bwack/VersaZIF64/README.md

# VersaZIF64

For gerbers please click the releases tab.
This project is based on the [Versa64Cart project](https://github.com/bwack/Versa64Cart).

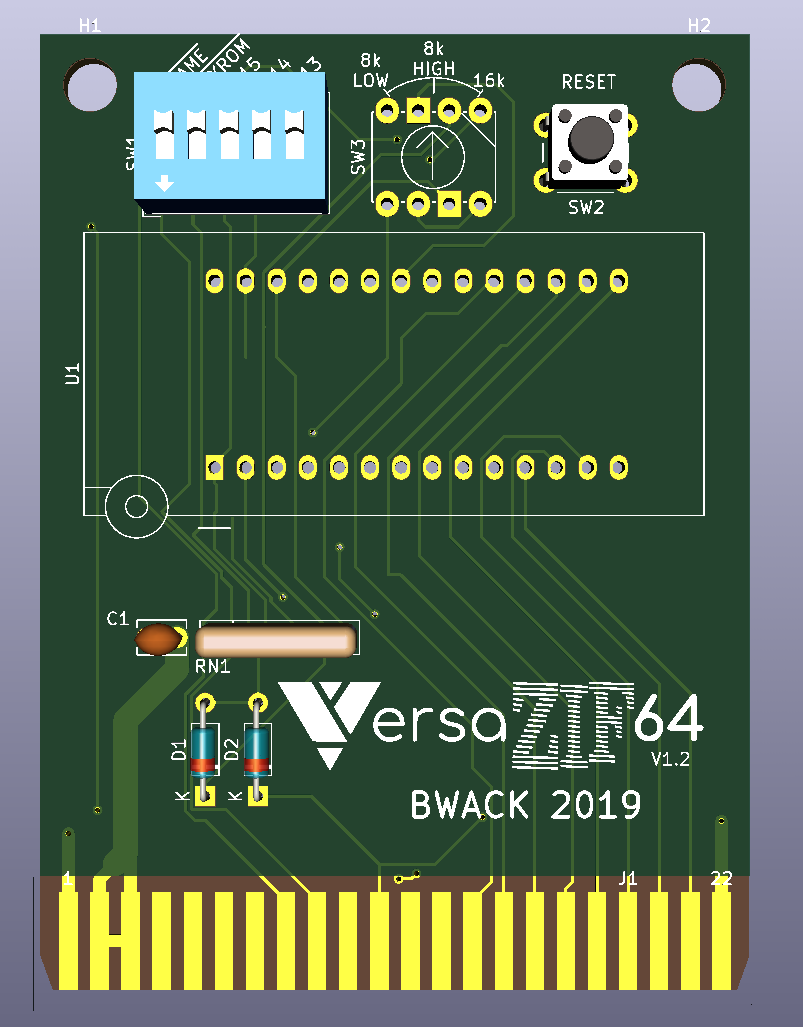
[picture p1: VersZIF64cart_3D.png]
VersaZIF64 3D
