bwack/VersaZIF64/VersZIF64cart.pdf

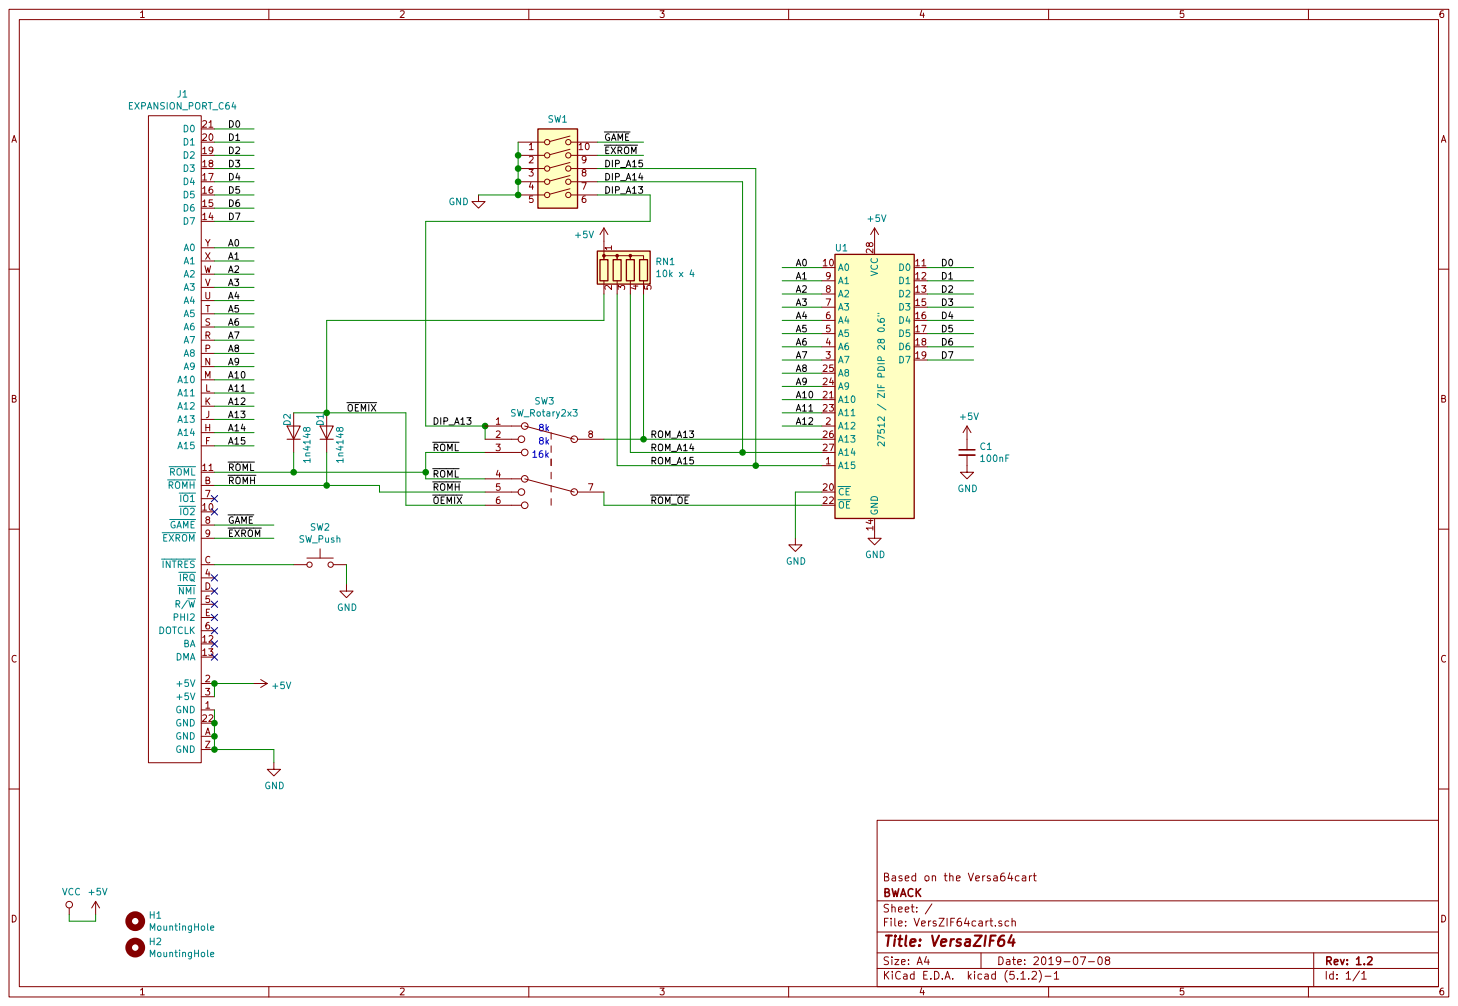
[picture p2: page 1]

File: VersZIF64cart.sch Sheet: / BWACK
