bwack/VersaZIF64/(list of files, drawings)

Other design files:
VersZIF64cart.dsn
