bwack/VersaZIF64/VersZIF64cart.kicad_pcb

## KiCad design VersZIF64cart.kicad_pcb (2019-07-08)

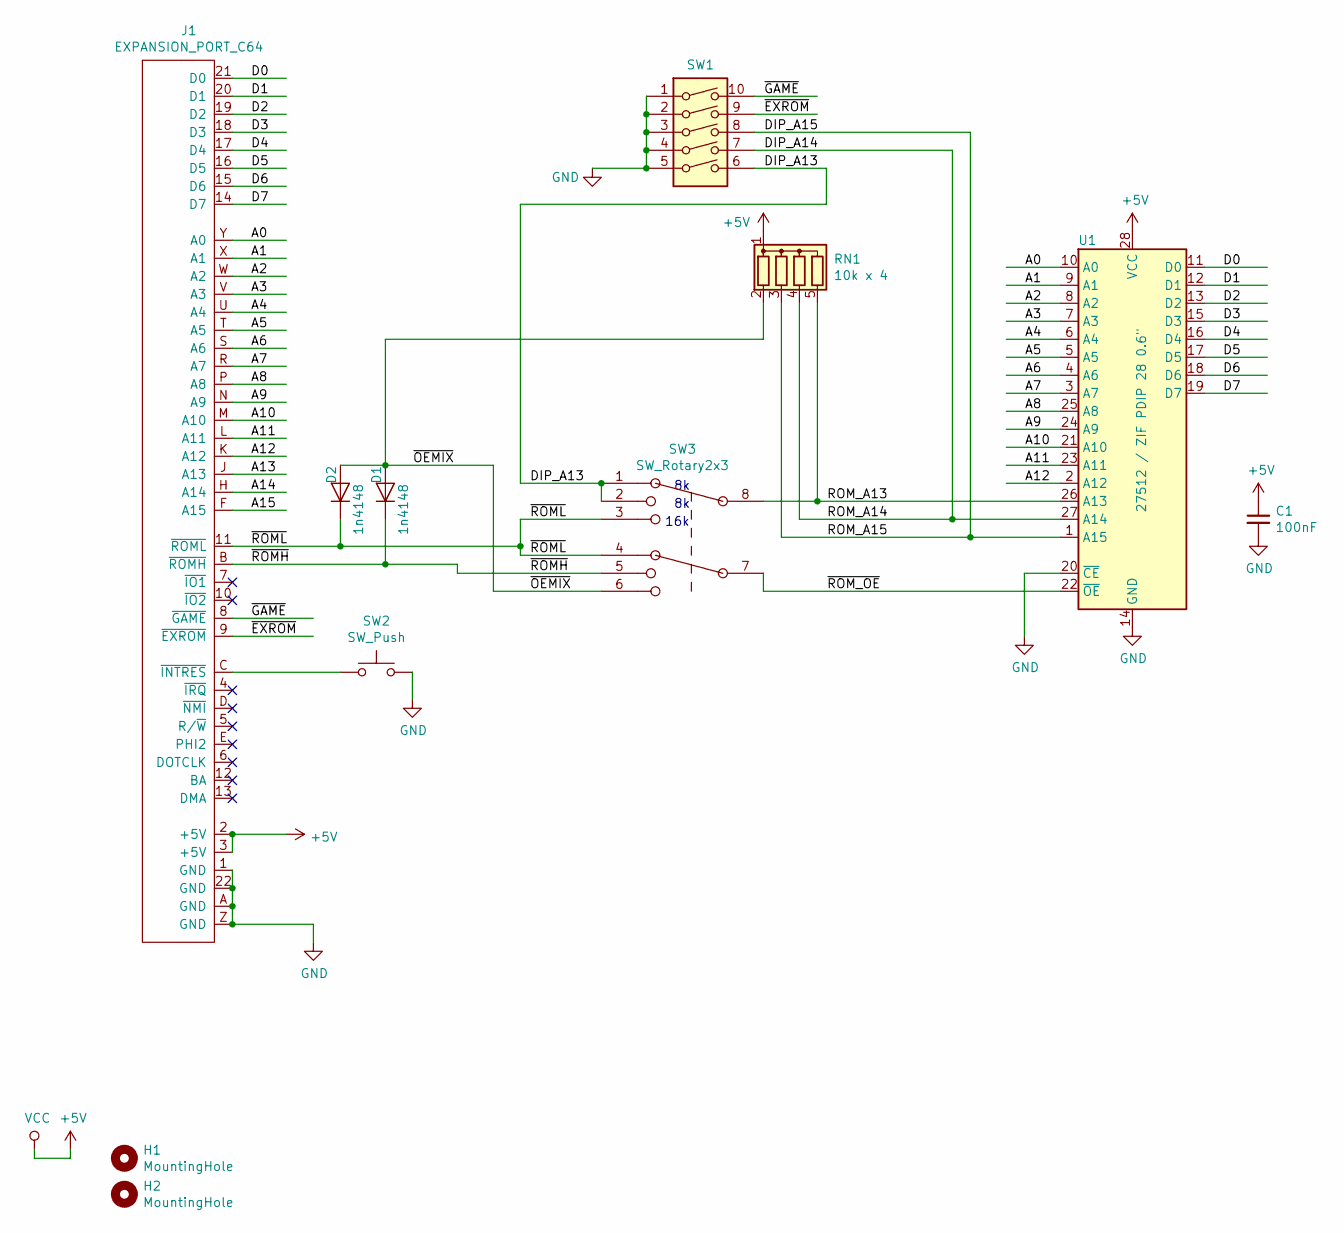
[picture p3: schematic VersZIF64cart.sch, VersaZIF64]

Parts:
C1: 100nF; C_Disc_D3.8mm_W2.6mm_P2.50mm
D1, D2: 1n4148; D_DO-35_SOD27_P7.62mm_Horizontal
H1, H2: MountingHole; MountingHole_4.3mm_M4_ISO7380
J1: EXPANSION_PORT_C64; C64_EXPANSION_PORT
RN1: 10k x 4; R_Array_SIP5
SW1: SW_DIP_x05; SW_DIP_SPSTx05_Slide_9.78x14.88mm_W7.62mm_P2.54mm
SW2: SW_Push; SW_PUSH_6mm_H5mm
SW3: SW_Rotary2x3; Nidec_SS-10-23NP-L-E_RotarySwitch_2x3
U1: 27512 / ZIF PDIP 28 0.6\"; DIP_Socket-28_W11.9_W12.7_W15.24_W17.78_W18.5_3M_228-1277-0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

Connections:
+5V: C1.1, J1.2 (+5V), J1.3 (+5V), RN1.1 (common), U1.28 (VCC)
/A0: J1.Y (A0), U1.10 (A0)
/A1: J1.X (A1), U1.9 (A1)
/A2: J1.W (A2), U1.8 (A2)
/A3: J1.V (A3), U1.7 (A3)
/A4: J1.U (A4), U1.6 (A4)
/A5: J1.T (A5), U1.5 (A5)
/A6: J1.S (A6), U1.4 (A6)
/A7: J1.R (A7), U1.3 (A7)
/A8: J1.P (A8), U1.25 (A8)
/A9: J1.N (A9), U1.24 (A9)
/A10: J1.M (A10), U1.21 (A10)
/A11: J1.L (A11), U1.23 (A11)
/A12: J1.K (A12), U1.2 (A12)
/A13: J1.J (A13)
/A14: J1.H (A14)
/A15: J1.F (A15)
/D0: J1.21 (D0), U1.11 (D0)
/D1: J1.20 (D1), U1.12 (D1)
/D2: J1.19 (D2), U1.13 (D2)
/D3: J1.18 (D3), U1.15 (D3)
/D4: J1.17 (D4), U1.16 (D4)
/D5: J1.16 (D5), U1.17 (D5)
/D6: J1.15 (D6), U1.18 (D6)
/D7: J1.14 (D7), U1.19 (D7)
/DIP_A13: SW1.6, SW3.1, SW3.2
/DIP_A14: RN1.4 (R3), SW1.7, U1.27 (A14)
/DIP_A15: RN1.3 (R2), SW1.8, U1.1 (A15)
/ROM_A13: RN1.5 (R4), SW3.8, U1.26 (A13)
/~EXROM~: J1.9 (~EXROM~), SW1.9
/~GAME~: J1.8 (~GAME~), SW1.10
/~OEMIX~: D1.2 (A), D2.2 (A), RN1.2 (R1), SW3.6
/~ROMH~: D1.1 (K), J1.B (~ROMH~), SW3.5
/~ROML~: D2.1 (K), J1.11 (~ROML~), SW3.3, SW3.4
/~ROM_OE~: SW3.7, U1.22 (~OE)
GND: C1.2, J1.1 (GND), J1.22 (GND), J1.A (GND), J1.Z (GND), SW1.1, SW1.2, SW1.3, SW1.4, SW1.5, SW2.2, U1.14 (GND), U1.20 (~CE)
unnamed: J1.C (~INTRES~), SW2.1

Notes on the sheet:
16k

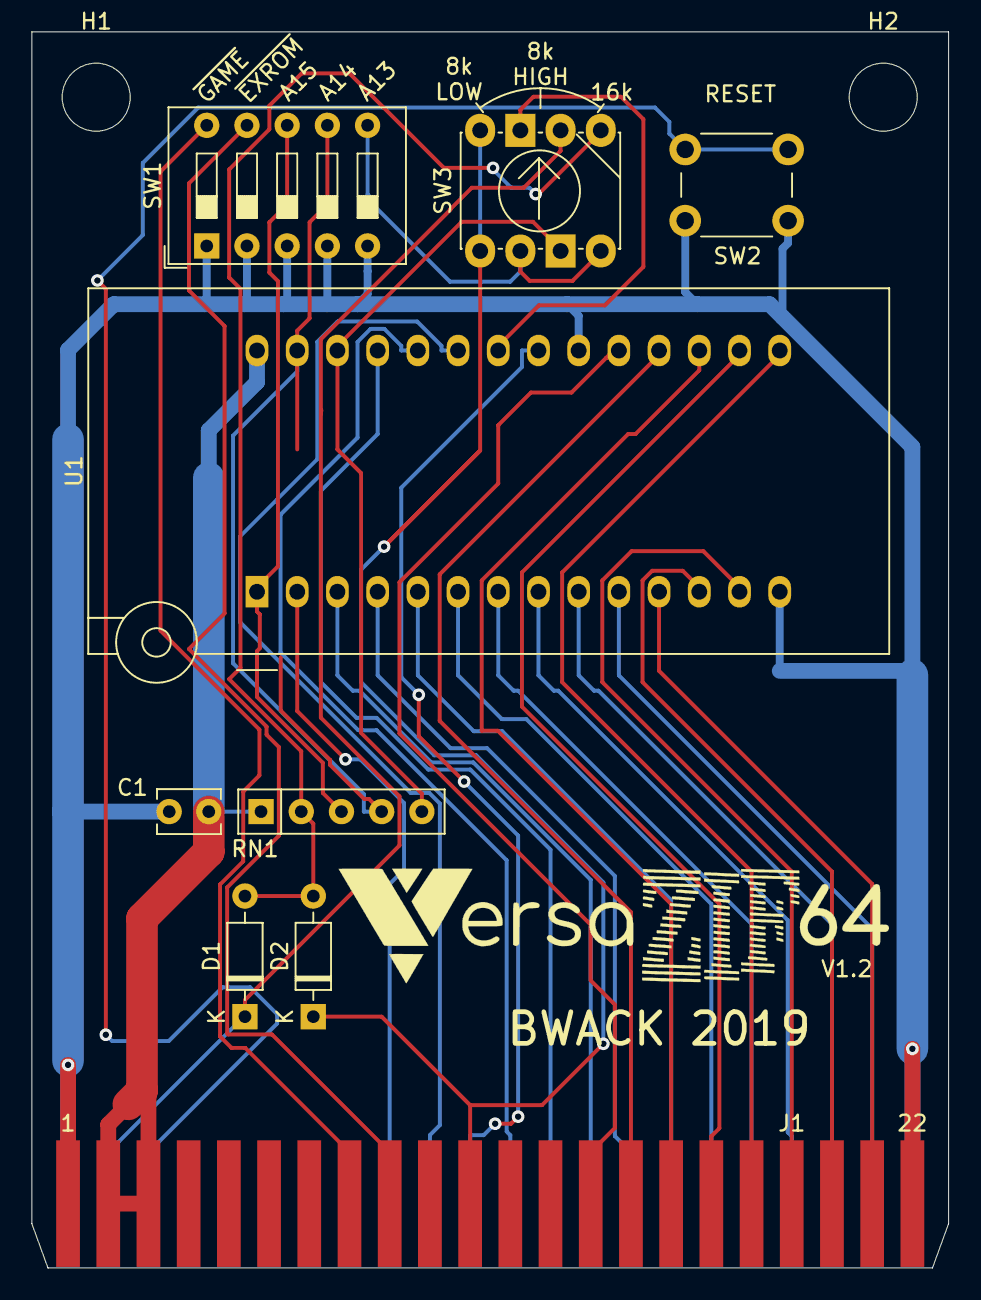
[picture p4: board VersZIF64cart.kicad_pcb from above]

Board: 2 copper layers, 57.9 x 78.1 mm, 11 parts (0 on the bottom side), 34 nets.
