bwack/VersaZIF64/(threads)

Thread 1 (2019-06-26):

ZIF socket swing arm only 2 mm from C64C case (v1.0)

bwack, 2019-06-26:
is ok distance from breadbin case but too close for comfort in C64C case, and I have only tested one model of ZIF sockets.

Closed 2019-07-03.

Thread 3 (2019-07-05):

silkscreen errors

bwack, 2019-07-05:
in v1.1
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

#GAME, #EXROM etc.
RESET

move them 5mm up.

Closed 2019-07-08.

Thread 4 (2024-11-15):

SW3

zentarot, 2024-11-15:
hello
If possible explain how the SW3 switch works, I couldn't find this switch and I read its datasheet but I don't understand, if possible explain how I can replace this switch with a jumper, also I know another project with a jumper available but printing the circuit of that project is more difficult than your project. Thank you for your guidance
