bwack/VersaZIF64/(commit log)

2019-06-22 pdf and 3D drawing
    [VersZIF64cart.kicad_pcb, VersZIF64cart.sch]
2019-07-08 VersaZIF64 1.2
    [VersZIF64cart.kicad_pcb, VersZIF64cart.sch]
